bdubyalock/AAE451_Team7/README.md

# AAE451_Team7
GitHub Repo for AAE 451 Senior Design Team 7
Use this for CAD and code.
