bdubyalock/AAE451_Team7/Interfacing Design Review.pptx

## Mothership-Glider Interfacing

Team Trident, Team 7

7

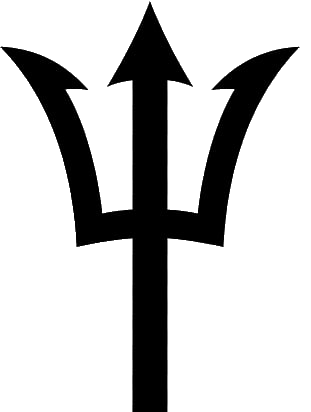
[picture p5: figure]

## Release mechanism

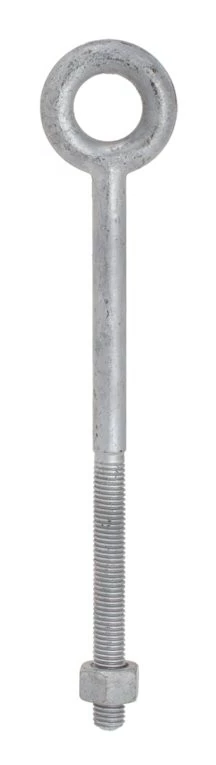
[picture p6: figure]
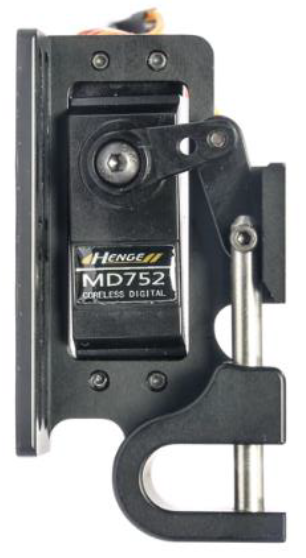
[picture p7: figure]
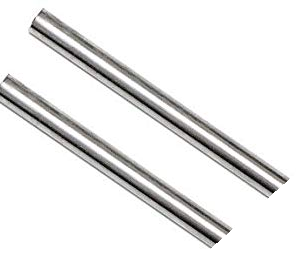
[picture p8: figure]

## Configuration

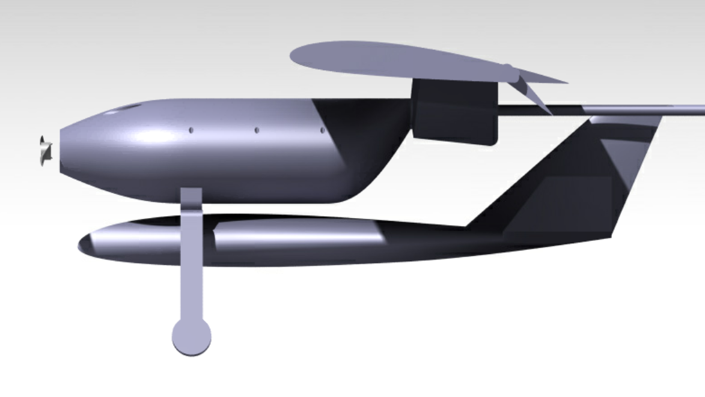
[picture p9: figure]

1 servo at the front
2 rods at the back

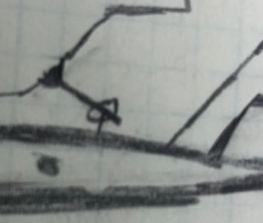
[picture p10: figure]

(top view) pin opening to the aft

## Slide 4

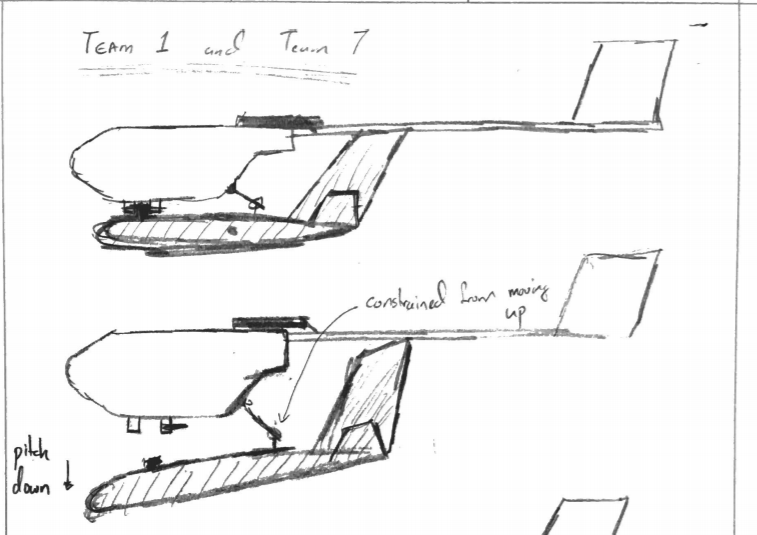
[picture p11: figure]

## Slide 5

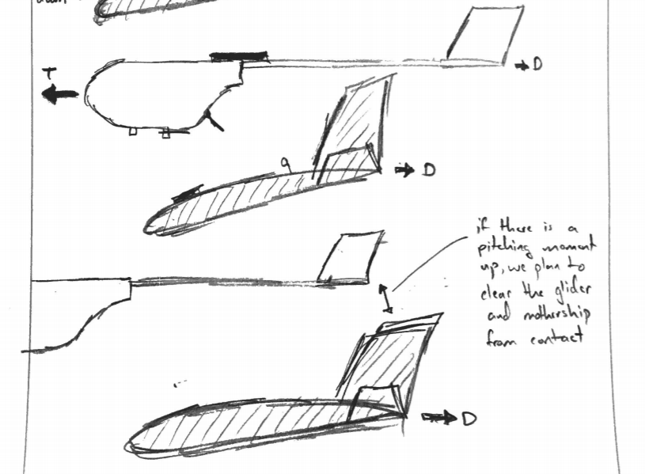
[picture p12: figure]
