bdubyalock/AAE451_Team7/PROPELLER_PDR_Design.xlsx

Sheet: RFP & Constraints
An electric UAV is needed to survey 10 km of roadway to detect surface damage. The UAV will fly at 20 m/sec at an altitude of 100 m carrying a 2 kg camera package. The UAV must be hand launched.
Two Constraints
•Cruise at 20 m/sec
•Hand Launch

Sheet: constraint
Criuse Speed |  |  |  | Hand Launch
 | rho | 1.225 | kg/m^3 | Clmax | 1.1
 | V | 18 | m/sec | Vlaunch | 9 | m/sec | 20 | mph
 | q | 198.45 | N/m^2 | q launch | 49.61 | N/m^2
 |  |  |  | W/S | 54.57 | N/m^2 | 0
 | AR | 5 |  |  | 54.57 | N/m^3 | 15
 | e | 0.9
 | Cdo | 0.0375
 | eta motor | 0.93
 | eta prop | 0.65
 | W/S | T/W | P/W
 | 20 | 0.3792225512 | 11.29198664
 | 22 | 0.3461087268 | 10.30596705
 | 24 | 0.3186326865 | 9.48782193
 | 26 | 0.2954934031 | 8.798811012
 | 28 | 0.2757615717 | 8.211262682
 | 30 | 0.2587557019 | 7.704884422
 | 32 | 0.2439646757 | 7.264456845
 | 34 | 0.2309976386 | 6.878341595
 | 36 | 0.2195505922 | 6.537486617
 | 38 | 0.2093835381 | 6.234745552
 | 40 | 0.2003044775 | 5.964401314
 | 42 | 0.1921579826 | 5.721825784
 | 44 | 0.1848168854 | 5.503232321
 | 46 | 0.1781761341 | 5.305492828
 | 48 | 0.1721481855 | 5.12600056
 | 50 | 0.1666595031 | 4.962565849
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
