bdubyalock/AAE451_Team7/Final_view1.jpg

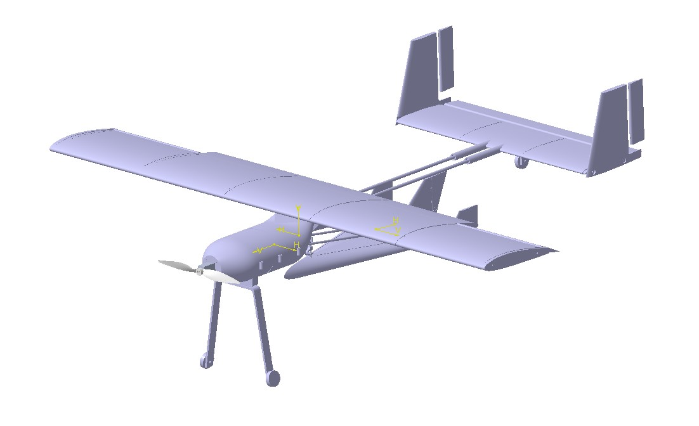
Final_view1.jpg
