bdubyalock/AAE451_Team7/Final_view2_color.jpg

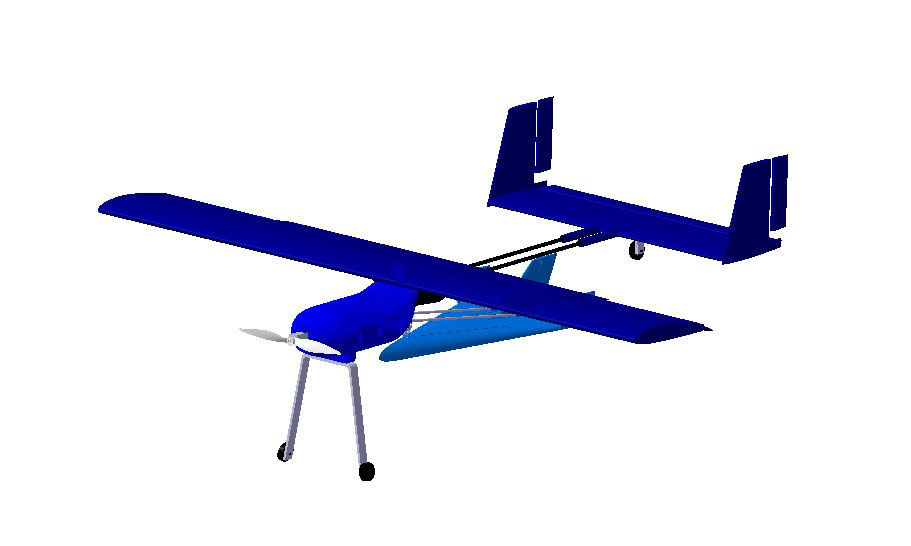
Final_view2_color.jpg
