bdubyalock/AAE451_Team7/FrontView.jpg

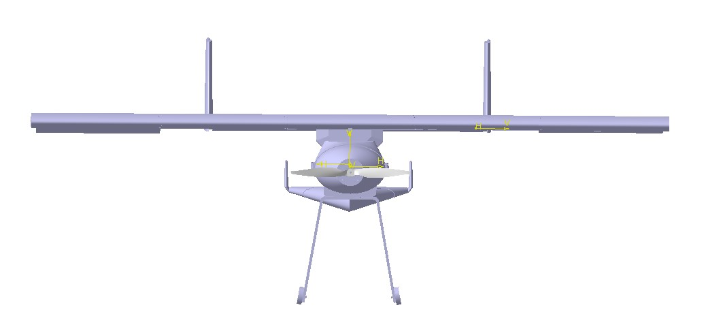
FrontView.jpg
