bdubyalock/AAE451_Team7/GliderAttachment.png

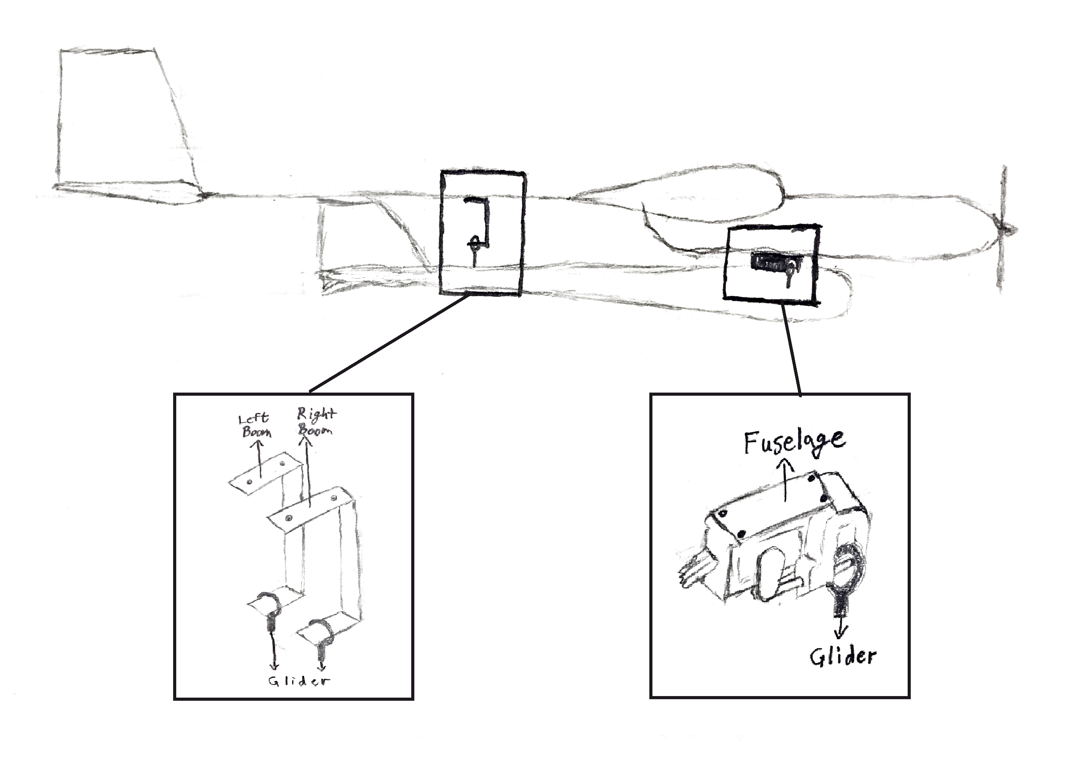
GliderAttachment.png
