bdubyalock/AAE451_Team7/SideView.jpg

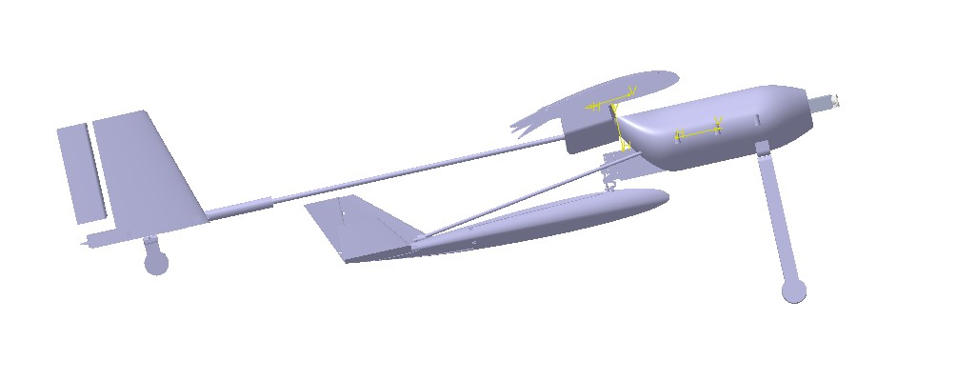
SideView.jpg
