bdubyalock/AAE451_Team7/ThreeView.jpg

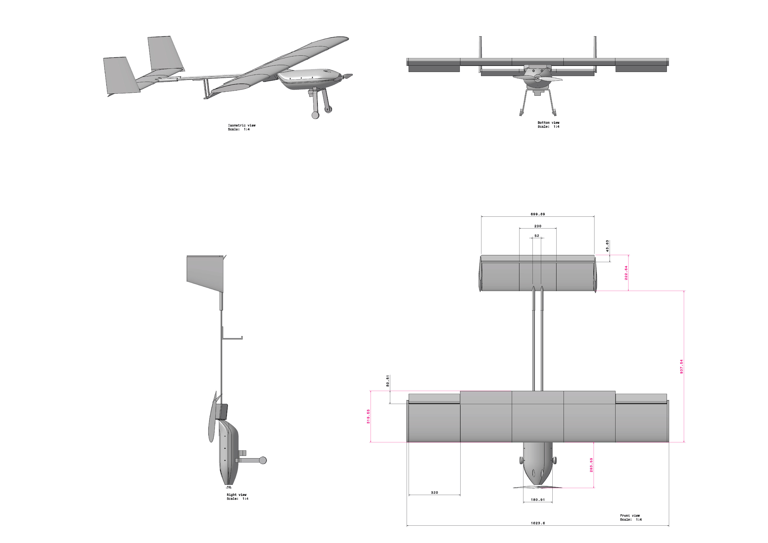
ThreeView.jpg
