bdubyalock/AAE451_Team7/TopView.jpg

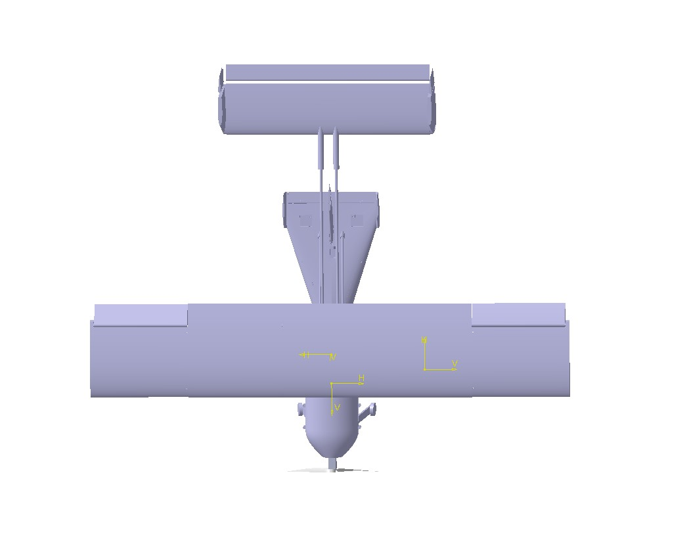
TopView.jpg
