bdubyalock/AAE451_Team7/CostSpreadsheet.xlsx

Sheet: Full
Task | Material Cost ($) | Labor Cost (Hours) | Labor Cost ($25/hr) | Total Cost | Labor Cost | 25
Preliminary Design Review
Team Design Meetings | $0.00 | 144.00 | $3600.00 | $3600.00
Report | $0.00 | 24.00 | $600.00 | $600.00
Project Plan Schedule
Develop | $0.00 | 6.00 | $150.00 | $150.00
Aerodynamics and Stability PDR
Aircraft Geometry | $0.00 | 12.00 | $300.00 | $300.00
Aerodynamic Performance | $0.00 | 5.00 | $125.00 | $125.00
Stability | $0.00 | 48.00 | $1200.00 | $1200.00
Propulsion PDR
Propeller Properties | $0.00 | 30.00 | $750.00 | $750.00
Aerodynamic Propeller Properites | $0.00 | 5.00 | $125.00 | $125.00
Gearbox Properties | $0.00 | 0.00 | $0.00 | $0.00
Electric Motor Properties | $0.00 | 3.00 | $75.00 | $75.00
Procedure Description | $0.00 | 1.00 | $25.00 | $25.00
Mission Requirements Analysis | $0.00 | 5.00 | $125.00 | $125.00
Structures and Weights PDR
Landing Gear | $0.00 | 6.00 | $150.00 | $150.00
Preliminary CAD | $0.00 | 5.00 | $125.00 | $125.00
Design Strategy
Analysis of Impulsive Loads | $0.00 | 4.00 | $100.00 | $100.00
Location, Configuraton, Special Structure, Load Analysis | $0.00 | 18.00 | $450.00 | $450.00
Longitudinal & Lateral tip-over analysis | $0.00 | 0.00 | $0.00 | $0.00
Tail Strike Analysis | $0.00 | 2.00 | $50.00 | $50.00
Weight Determination
Center of Gravity | $0.00 | 3.00 | $75.00 | $75.00
Moments/Products of Inertia | $0.00 | 0.50 | $12.50 | $12.50
Complete Tabular listing of all parts, locations, weights | $0.00 | 3.00 | $75.00 | $75.00
Geometric Layout
Geometry of Wing Spars | $0.00 | 1.00 | $25.00 | $25.00
Location of Wing Ribs & Stringers | $0.00 | 1.00 | $25.00 | $25.00
Wing Coverings, Materials of Wing Components | $0.00 | 1.00 | $25.00 | $25.00
Analysis of Wing Loads
V-n Diagram | $0.00 | 24.00 | $600.00 | $600.00
Max bending/torsional loading coefficients | $0.00 | 22.00 | $550.00 | $550.00
Load distribution @ max wing loading | $0.00 | 0.50 | $12.50 | $12.50
Max root bending moment | $0.00 | 0.50 | $12.50 | $12.50
Final Properties of Wing Box | $0.00 | 5.00 | $125.00 | $125.00
Assumptions/Failure conditions/Vertical Deflections | $0.00 | 2.00 | $50.00 | $50.00
Fuselage and Tail Structure
Analysis of Wing Fuselage Attachment | $0.00 | 2.00 | $50.00 | $50.00
Geometric layout of fuselage structure | $0.00 | 2.00 | $50.00 | $50.00
Geometric Layout of horizontal tail structure | $0.00 | 2.00 | $50.00 | $50.00
Geometric Layout of vertical tail structure | $0.00 | 2.00 | $50.00 | $50.00
Parts Acquisition List
Develop List | $0.00 | 2.00 | $50.00 | $50.00
CAD, Prototyping, Economic, Test Plan
CAD | $0.00 | 100.00 | $2500.00 | $2500.00
Manufacturing Report | $0.00 | 18.00 | $450.00 | $450.00
Build Schedule | $0.00 | 1.00 | $25.00 | $25.00
Economic Plan | $0.00 | 3.00 | $75.00 | $75.00
Flight Test Plan | $0.00 | 1.00 | $25.00 | $25.00
Critical Design Review (CDR)
Presentation Compilation | $0.00 | 6.00 | $150.00 | $150.00
Presentation Delivery | $0.00 | 3.00 | $75.00 | $75.00
Aerodynamic Analysis | $0.00 | 4.00 | $100.00 | $100.00
D&C Analysis | $0.00 | 6.00 | $150.00 | $150.00
Structural Analysis | $0.00 | 3.00 | $75.00 | $75.00
Propulsion Analysis | $0.00 | 4.00 | $100.00 | $100.00
Vehicle Performance Prediction | $0.00 | 6.00 | $150.00 | $150.00
Unique Aspects | $0.00 | 1.00 | $25.00 | $25.00
Remaining Design Problems/Solutions | $0.00 | 1.00 | $25.00 | $25.00
Conclusions | $0.00 | 1.00 | $25.00 | $25.00
Paper Copies of CDR Slides | $0.00 | 0.50 | $12.50 | $12.50
Aircraft Manufacturing
Main Wing | $15.35 | 2.00 | $50.00 | $65.35
Horizontal Stabilizer | $3.84 | 2.00 | $50.00 | $53.84
Vertical Stabilizers | $3.84 | 2.00 | $50.00 | $53.84
Fuselage | $5.76 | 4.00 | $100.00 | $105.76
Electrical Components | $900.00 | 0.00 | $0.00 | $900.00
Booms | $160.00 | 2.00 | $50.00 | $210.00
Landing Gear | $30.00 | 6.00 | $150.00 | $180.00
Aircraft Assembly
Structural Assembly | $0.00 | 15.00 | $375.00 | $375.00
Wiring | $40.00 | 10.00 | $250.00 | $290.00
Individual Component Testing | $0.00 | 10.00 | $250.00 | $250.00
Flight Test
Flight Readiness Review | $0.00 | 6.00 | $150.00 | $150.00
"Professional Pilot" Review | $0.00 | 6.00 | $150.00 | $150.00
System Ground Test | $0.00 | 12.00 | $300.00 | $300.00
Propulsion Check | $0.00 | 10.00 | $250.00 | $250.00
Mission Mechanism Check | $0.00 | 6.00 | $150.00 | $150.00
Overall Flight Test | $0.00 | 20.00 | $500.00 | $500.00
Final Flight (for score) | $0.00 | 20.00 | $500.00 | $500.00
Final Project Poster Presentation
Develop | $0.00 | 20.00 | $500.00 | $500.00
Present | $0.00 | 6.00 | $150.00 | $150.00
Final Design Report
Develop Report | $0.00 | 40.00 | $1000.00 | $1000.00
TOTALS: | $1158.78 | 749.00 | $18725.00 | $19883.78

Sheet: Sums
Task | Material Cost ($) | Labor Cost (Hours) | Labor Cost ($25/hr) | Total Cost | Labor Cost | 25 | Non-Concise
Preliminary Design Review | $0.00 | $168.00 | $4200.00 | $4200.00
Team Design Meetings | $0.00 | 144.00 | $3600.00 | $3600.00 |  |  | x
Report | $0.00 | 24.00 | $600.00 | $600.00 |  |  | x
Project Plan Schedule | $0.00 | $6.00 | $150.00 | $150.00
Develop | $0.00 | 6.00 | $150.00 | $150.00 |  |  | x
Aerodynamics and Stability PDR | $0.00 | $65.00 | $1625.00 | $1625.00
Aircraft Geometry | $0.00 | 12.00 | $300.00 | $300.00 |  |  | x
Aerodynamic Performance | $0.00 | 5.00 | $125.00 | $125.00 |  |  | x
Stability | $0.00 | 48.00 | $1200.00 | $1200.00 |  |  | x
Propulsion PDR | $0.00 | $44.00 | $1100.00 | $1100.00
Propeller Properties | $0.00 | 30.00 | $750.00 | $750.00 |  |  | x
Aerodynamic Propeller Properites | $0.00 | 5.00 | $125.00 | $125.00 |  |  | x
Gearbox Properties | $0.00 | 0.00 | $0.00 | $0.00 |  |  | x
Electric Motor Properties | $0.00 | 3.00 | $75.00 | $75.00 |  |  | x
Procedure Description | $0.00 | 1.00 | $25.00 | $25.00 |  |  | x
Mission Requirements Analysis | $0.00 | 5.00 | $125.00 | $125.00 |  |  | x
Structures and Weights PDR | $0.00 | $106.50 | $2662.50 | $2662.50
Landing Gear | $0.00 | 6.00 | $150.00 | $150.00 |  |  | x
Preliminary CAD | $0.00 | 5.00 | $125.00 | $125.00 |  |  | x
Design Strategy |  |  |  |  |  |  | x
Analysis of Impulsive Loads | $0.00 | 4.00 | $100.00 | $100.00 |  |  | x
Location, Configuraton, Special Structure, Load Analysis | $0.00 | 18.00 | $450.00 | $450.00 |  |  | x
Longitudinal & Lateral tip-over analysis | $0.00 | 0.00 | $0.00 | $0.00 |  |  | x
Tail Strike Analysis | $0.00 | 2.00 | $50.00 | $50.00 |  |  | x
Weight Determination |  |  |  |  |  |  | x
Center of Gravity | $0.00 | 3.00 | $75.00 | $75.00 |  |  | x
Moments/Products of Inertia | $0.00 | 0.50 | $12.50 | $12.50 |  |  | x
Complete Tabular listing of all parts, locations, weights | $0.00 | 3.00 | $75.00 | $75.00 |  |  | x
Geometric Layout |  |  |  |  |  |  | x
Geometry of Wing Spars | $0.00 | 1.00 | $25.00 | $25.00 |  |  | x
Location of Wing Ribs & Stringers | $0.00 | 1.00 | $25.00 | $25.00 |  |  | x
Wing Coverings, Materials of Wing Components | $0.00 | 1.00 | $25.00 | $25.00 |  |  | x
Analysis of Wing Loads |  |  |  |  |  |  | x
V-n Diagram | $0.00 | 24.00 | $600.00 | $600.00 |  |  | x
Max bending/torsional loading coefficients | $0.00 | 22.00 | $550.00 | $550.00 |  |  | x
Load distribution @ max wing loading | $0.00 | 0.50 | $12.50 | $12.50 |  |  | x
Max root bending moment | $0.00 | 0.50 | $12.50 | $12.50 |  |  | x
Final Properties of Wing Box | $0.00 | 5.00 | $125.00 | $125.00 |  |  | x
Assumptions/Failure conditions/Vertical Deflections | $0.00 | 2.00 | $50.00 | $50.00 |  |  | x
Fuselage and Tail Structure |  |  |  |  |  |  | x
Analysis of Wing Fuselage Attachment | $0.00 | 2.00 | $50.00 | $50.00 |  |  | x
Geometric layout of fuselage structure | $0.00 | 2.00 | $50.00 | $50.00 |  |  | x
Geometric Layout of horizontal tail structure | $0.00 | 2.00 | $50.00 | $50.00 |  |  | x
Geometric Layout of vertical tail structure | $0.00 | 2.00 | $50.00 | $50.00 |  |  | x
Parts Acquisition List | $0.00 | $2.00 | $50.00 | $50.00
Develop List | $0.00 | 2.00 | $50.00 | $50.00 |  |  | x
CAD, Prototyping, Economic, Test Plan | $0.00 | $123.00 | $3075.00 | $3075.00
CAD | $0.00 | 100.00 | $2500.00 | $2500.00 |  |  | x
Manufacturing Report | $0.00 | 18.00 | $450.00 | $450.00 |  |  | x
Build Schedule | $0.00 | 1.00 | $25.00 | $25.00 |  |  | x
Economic Plan | $0.00 | 3.00 | $75.00 | $75.00 |  |  | x
Flight Test Plan | $0.00 | 1.00 | $25.00 | $25.00 |  |  | x
Critical Design Review (CDR) | $0.00 | $35.50 | $887.50 | $887.50
Presentation Compilation | $0.00 | 6.00 | $150.00 | $150.00 |  |  | x
Presentation Delivery | $0.00 | 3.00 | $75.00 | $75.00 |  |  | x
Aerodynamic Analysis | $0.00 | 4.00 | $100.00 | $100.00 |  |  | x
D&C Analysis | $0.00 | 6.00 | $150.00 | $150.00 |  |  | x
Structural Analysis | $0.00 | 3.00 | $75.00 | $75.00 |  |  | x
Propulsion Analysis | $0.00 | 4.00 | $100.00 | $100.00 |  |  | x
Vehicle Performance Prediction | $0.00 | 6.00 | $150.00 | $150.00 |  |  | x
Unique Aspects | $0.00 | 1.00 | $25.00 | $25.00 |  |  | x
Remaining Design Problems/Solutions | $0.00 | 1.00 | $25.00 | $25.00 |  |  | x
Conclusions | $0.00 | 1.00 | $25.00 | $25.00 |  |  | x
Paper Copies of CDR Slides | $0.00 | 0.50 | $12.50 | $12.50 |  |  | x
Aircraft Manufacturing | $1118.78 | $18.00 | $450.00 | $1568.78
Main Wing | $15.35 | 2.00 | $50.00 | $65.35 |  |  | x
Horizontal Stabilizer | $3.84 | 2.00 | $50.00 | $53.84 |  |  | x
Vertical Stabilizers | $3.84 | 2.00 | $50.00 | $53.84 |  |  | x
Fuselage | $5.76 | 4.00 | $100.00 | $105.76 |  |  | x
Electrical Components | $900.00 | 0.00 | $0.00 | $900.00 |  |  | x
Booms | $160.00 | 2.00 | $50.00 | $210.00 |  |  | x
Landing Gear | $30.00 | 6.00 | $150.00 | $180.00 |  |  | x
Aircraft Assembly | $40.00 | $35.00 | $875.00 | $915.00
Structural Assembly | $0.00 | 15.00 | $375.00 | $375.00 |  |  | x
Wiring | $40.00 | 10.00 | $250.00 | $290.00 |  |  | x
Individual Component Testing | $0.00 | 10.00 | $250.00 | $250.00 |  |  | x
Flight Test | $0.00 | $80.00 | $2000.00 | $2000.00
Flight Readiness Review | $0.00 | 6.00 | $150.00 | $150.00 |  |  | x
"Professional Pilot" Review | $0.00 | 6.00 | $150.00 | $150.00 |  |  | x
System Ground Test | $0.00 | 12.00 | $300.00 | $300.00 |  |  | x
Propulsion Check | $0.00 | 10.00 | $250.00 | $250.00 |  |  | x
Mission Mechanism Check | $0.00 | 6.00 | $150.00 | $150.00 |  |  | x
Overall Flight Test | $0.00 | 20.00 | $500.00 | $500.00 |  |  | x
Final Flight (for score) | $0.00 | 20.00 | $500.00 | $500.00 |  |  | x
Final Project Poster Presentation | $0.00 | $26.00 | $650.00 | $650.00
Develop | $0.00 | 20.00 | $500.00 | $500.00 |  |  | x
Present | $0.00 | 6.00 | $150.00 | $150.00 |  |  | x
Final Design Report | $0.00 | $40.00 | $1000.00 | $1000.00
Develop Report | $0.00 | 40.00 | $1000.00 | $1000.00 |  |  | x
TOTALS: | $1158.78 | $749.00 | $18725.00 | $19883.78
