bdubyalock/AAE451_Team7/WeightEstimate.xlsx

Sheet: Filament Weight
PLA |  | ABS
PLA used [mm] | 3800 | ABS used [mm] | 50000
PLA diameter [mm] | 1.75 | ABS diameter [mm] | 1.75
PLA radius [mm] | 0.875 | ABS radius [mm] | 0.875
PLA volume [mm3] | 9140.071127 | ABS volume [mm3] | 120264.0938
PLA volume [cm3] | 9.14 | ABS volume [cm3] | 120.26
PLA density [g/cm3] | 1.25 | ABS density [g/cm3] | 1.04
PLA weight [g] | 11.43 | ABS weight [g] | 125.07
PLA weight [oz] | 0.40 | ABS weight [oz] | 4.41

Sheet: Part Weight Estimate
Part | Volume (cm^3) | Material | Weight (g) | Weight (kg) | NEW ESTIMATE (g) | NEW ESTIMATE (kg) | Total Weight (kg)
FuselageBodyTop | 792.863 | PLA | 991.07875 | 0.99107875 | 458.5588931 | 0.4585588931 | 13.59031875
FuselageBodyBase | 1148.221 | PLA | 1435.27625 | 1.43527625 | 664.0831402 | 0.6640831402 | 11.77631875
HSMID | 332.457 | PLA | 415.57125 | 0.41557125 | 192.2792638 | 0.1922792638
HSLH | 232.052 | PLA | 290.065 | 0.290065 | 134.2091991 | 0.1342091991 | Actual (kg)
HSRH | 232.052 | PLA | 290.065 | 0.290065 | 134.2091991 | 0.1342091991 | 7.359681971 | W Glider
WingMID | 643.093 | PLA | 803.86625 | 0.80386625 | 372 | 0.372 | 5.545681971 | W/o Glider
Wing_L_out | 444.547 | PLA | 555.68375 | 0.55568375 | 257.1074451 | 0.2571074451
Wing_L_in | 444.547 | PLA | 555.68375 | 0.55568375 | 257.1074451 | 0.2571074451
Wing_R_out | 444.547 | PLA | 555.68375 | 0.55568375 | 257.1074451 | 0.2571074451
Wing_L_in | 444.547 | PLA | 555.68375 | 0.55568375 | 257.1074451 | 0.2571074451
Elevator | 200.676 | PLA | 250.845 | 0.250845 | 116.0626293 | 0.1160626293
Flap x3 | 244.167 | PLA | 305.20875 | 0.91562625 | 141.2160099 | 0.1412160099
Flap x2 | 229.525 | PLA | 286.90625 | 0.5738125 | 132.7476877 | 0.1327476877
WingEndCap | 26.807 | PLA | 33.50875 | 0.0670175 | 15.50405082 | 0.01550405082
WingAttachment | 687.183 | PLA | 858.97875 | 0.85897875 | 397.4379884 | 0.3974379884
VS x2 | 449.052 | PLA | 561.315 | 1.12263 | 259.7129492 | 0.2597129492
Rudder | 58.841 | PLA | 73.55125 | 0.07355125 | 34.03118045 | 0.03403118045
Propeller |  |  | 46 | 0.046 |  | 0.046
Motor |  |  | 207 | 0.207 |  | 0.207
ESC |  |  | 106 | 0.106 |  | 0.106
Wires |  |  | 100 | 0.1 |  | 0.1
Battery |  |  | 600 | 0.6 |  | 0.6
Servos |  |  | 171 | 0.171 |  | 0.171
Carbon fiber rods |  |  | 235.2 | 0.2352 |  | 0.2352
glider |  |  |  | 1.814 |  | 1.814
