bdubyalock/AAE451_Team7/AA-SM-518 Loads - V-n Diagram -Sarah.xlsx

Sheet: READ ME
Author: | R. Abbott |  | Total Report Pages:
Check: |  |  | Report:
Date: |  |  | Revision:
Section Number: |  |  | Sheet Name | IMPORTANT INFORMATION
Report Title:
Section:
 | IMPORTANT INFORMATION
About us:
Established in Canada 2008 we relocated to Grand Cayman in 2015. Abbott Aerospace SEZC Ltd. specializes in helping our partners bring the best aircraft product to market in the shortest time. We help you define your aircraft and execute your development program.
About the Abbott Aerospace Analysis Spreadsheets:
Our in-house structural analysis toolbox is our collection of spreadsheets, we make these available for free to anyone who wants to use them. To keep up to date with our latest spreadsheet news and subscibe to our regular newsletter please click this link.
 |  |  | http://www.abbottaerospace.com/subscribe
The spreadsheets are intended to be used by engineers. They are not protected software packages and can be changed in every way by the user.
All of our spreadsheets are provided 'as is' with no warranty or guarantee explicitly given or implied. You use these spreadsheets at your own risk. The Author will not be liable for data loss, damages, loss of profits or any other kind of loss while using or misusing these spreadsheets We have made every reasonable effort to remove all errors but some may still exist and all analysis work should be thoroughly checked. If you do find errors plese notify us at:
 |  | spreadsheets@abbottaerospace.com
Proprietary information:
The spreadsheets contain no proprietary information from outside of Abbott Aerospace SEZC Ltd. If you think that we have used proprietary information inappropriately please let us know.
Abbott Aerospace SEZC Ltd. grants the user the right to use, modify, reproduce and redistribute these spreadsheets. We just ask that if possible you maintain a credit naming Abbott Aerospace SEZC Ltd. as the source.
Our analysis spreadsheets in general do not use Visual Basic routines and the outcome of the analysis in the spreadsheets rely solely on native Excel functions. The display of the math in these sheets rely on the XL-Viking add-in and the spreadsheets will not display correcly if the add-in is not installed.
To find out more about the Xl-Viking Add-in and to download it for free:
 |  |  | http://www.xl-viking.com/download-free-trial/
Support:
You can help support the work of the Abbott Aerospace Technical Library. We provide all of our library services without a mandatory charge. We rely on the goodwill of our users making voluntary donatations to help us support and expand the services we provide. Click the link below to make a donation.
Find out more about the Design and Analysis services provided by Abbott Aerospace
 |  |  | http://www.abbottaerospace.com/engineering-services

Sheet: Analysis
Author: | R. Abbott |  |  | Total Report Pages: | 1 |  |  |  |  | Page | Title | Sub | Sub | Sub | Fig | Table | Running Counts |  | Total Sheet Pages: | 1
Check: |  |  |  | Report: | AA-SM-518 |  |  |  |  | No | No | Title | Title | Title | No | No |  |  | Total Title No: | 0
Date: | 7/16/2016 |  |  | Revision: | IR |  |  |  |  |  |  |  |  |  |  |  |  |  | Total Sub No: | 0
Section Number: |  |  |  | Sheet Name | V-n DIAGRAM |  |  |  |  |  |  |  |  |  |  |  |  |  | Total Sub No: | 0
Report Title: | STANDARD SPREADSHEET METHOD |  |  |  |  |  |  |  |  |  |  |  |  |  |  |  |  |  | Total Sub No: | 0
Section: |  |  |  |  |  |  |  |  |  |  |  |  |  |  |  |  |  |  | Total Fig No: | 0
 |  |  |  |  |  |  |  |  |  |  |  |  |  |  |  |  |  |  | Total Table No: | 0
 |  |  | Author: | R. Abbott |  |  | Document Number: | AA-SM-518
 |  |  | Check: |  |  |  | Revision Level : | IR |  | 1
 |  |  | Date: | 7/16/2016 |  |  | Page: | 1 of 1 | 1
 |  |  | Title: | STANDARD SPREADSHEET METHOD
V-n DIAGRAM
 |  |  | Maneuver |  |  |  | Gust |  |  |  |  |  |  |  |  |  |  | Point A: | V = |  | V = | 62.6 | GUST LINES
 |  |  | Normal |  | Utility |  |  |  |  |  |  |  |  |  |  |  |  |  | n = |  | n = | 4.40 |  |  |  |  |  | 63.0 | 5.75
 |  |  | +ve | -ve | +ve | -ve | +ve | -ve |  |  |  |  |  |  |  |  |  |  |  |  |  |  | 0 | 1 | 1 | 1 | 1 | 88.2 | 3.68
vA = | 62.6 | kts (EAS) | 4.60 | -1.84 | 4.40 | -1.76 |  |  |  |  |  |  |  |  |  |  |  | Point D: | V = |  | V = | 88.2 | 63.0 | 5.75 | -3.50 |  |  | 88.2 | -1.50
vC = | 63.0 | kts (EAS) | 4.60 | -1.84 | 4.40 | -1.76 | 5.75 | -3.50 |  |  |  |  |  |  |  |  |  |  | n = |  | n = | 4.40 |  |  |  |  |  | 63.0 | -3.50
vD = | 88.2 | kts (EAS) | 4.60 | 0.00 | 4.40 | -1.00 | 3.68 | -1.50 |  |  |  |  |  |  |  |  |  |  |  |  |  |  |  |  |  |  |  | 63.0 | 5.75
vS1 = | 29.2 | kts (EAS) |  |  |  |  |  |  |  |  |  |  |  |  |  |  |  | Point E: | V = |  | V = | 88.2 | 0 |  |  | 1 | 1
 |  |  |  |  |  |  |  |  |  |  |  |  |  |  |  |  |  |  | n = |  | n = | -1.00 | 88.2 |  |  | 3.68 | -1.50
The flight envelope is determined in accordance with 23.333
 |  |  |  |  |  |  |  |  |  |  |  |  |  |  |  |  |  | Point F: | V = |  | V = | 63.0
 |  |  |  |  |  |  |  |  |  |  |  |  |  |  |  |  |  |  | n = |  | n = | -3.50
 |  |  |  |  |  |  |  |  |  |  |  |  |  |  |  |  |  | Point G: | V = |  | V = | 62.6
 |  |  |  |  |  |  |  |  |  |  |  |  |  |  |  |  |  |  | n = |  | n = | -1.76
 |  |  |  |  |  |  |  |  |  |  |  |  |  |  |  |  |  | Point C: | V = |  | V = | 63.0
 |  |  |  |  |  |  |  |  |  |  |  |  |  |  |  |  |  |  | n = |  | n = | 5.75
 |  |  |  |  |  |  |  |  |  |  |  |  |  |  |  |  |  |  | 62.6 | 4.60 | 62.6 | 4.40
 |  |  |  |  |  |  |  |  |  |  |  |  |  |  |  |  |  |  | 88.2 | 4.60 | 88.2 | 4.4
 |  |  |  |  |  |  |  |  |  |  |  |  |  |  |  |  |  |  | 88.2 | 0.00 | 88.2 | -1.00
 |  |  |  |  |  |  |  |  |  |  |  |  |  |  |  |  |  |  | 63.0 | -1.84 | 63.0 | -1.76
 |  |  |  |  |  |  |  |  |  |  |  |  |  |  |  |  |  |  | 62.6 | -1.84 | 62.6 | -1.76
 |  |  |  |  |  |  |  |  |  |  |  |  |  |  |  |  |  |  | Normal |  | Utility
 |  |  |  |  |  |  |  |  |  |  |  |  |  |  |  |  |  |  |  |  |  |  | 29.2 | 32.95370989 | 1.221001221 | 0.969
 |  |  |  |  |  |  |  |  |  |  |  |  |  |  |  |  |  | 62.55652319 | 4.60 | -1.84 | 4.40 | -1.76 |  | 26.05219515 | 0.7631257631
 |  |  |  |  |  |  |  |  |  |  |  |  |  |  |  |  |  | 59.64530458 | 4.18 | -1.67 | 4.00 | -1.60
 |  |  |  |  |  |  |  |  |  |  |  |  |  |  |  |  |  | 54.44846461 | 3.49 | -1.39 | 3.33 | -1.33 |  | 32.95370989 | -0.4884004884 | -0.388
 |  |  |  |  |  |  |  |  |  |  |  |  |  |  |  |  |  | 47.75446253 | 2.68 | -1.07 | 2.56 | -1.03 |  | 26.05219515 | -0.3052503053
 |  |  |  |  |  |  |  |  |  |  |  |  |  |  |  |  |  | 40.35988719 | 1.92 | -0.77 | 1.83 | -0.73
 |  |  |  |  |  |  |  |  |  |  |  |  |  |  |  |  |  | 32.95370989 | 1.28 | -0.51 | 1.22 | -0.49
 |  |  |  |  |  |  |  |  |  |  |  |  |  |  |  |  |  | 26.05219515 | 0.80 | -0.32 | 0.76 | -0.31 | 29.2 | -0.388
 |  |  |  |  |  |  |  |  |  |  |  |  |  |  |  |  |  | 24.83979345 | 0.73 | -0.29 | 0.69 | -0.28 | 29.2 | 0.969
 |  |  |  |  |  |  |  |  |  |  |  |  |  |  |  |  |  | 18.5144889 | 0.40 | -0.16 | 0.39 | -0.15
 |  |  |  |  |  |  |  |  |  |  |  |  |  |  |  |  |  | 13.43182198 | 0.21 | -0.08 | 0.20 | -0.08
 |  |  |  |  |  |  |  |  |  |  |  |  |  |  |  |  |  | 9.497732405 | 0.11 | -0.04 | 0.10 | -0.04
 |  | Utility Category Maneuver Envelope |  |  |  |  |  |  |  |  |  |  |  |  |  |  |  | 6.715910989 | 0.05 | -0.02 | 0.05 | -0.02
 |  | Gust Lines |  |  |  |  |  |  |  |  |  |  |  |  |  |  |  | 4.748866202 | 0.03 | -0.01 | 0.03 | -0.01
 |  | Normal Category Maneuver Envelope |  |  |  |  |  |  |  |  |  |  |  |  |  |  |  | 3.357955495 | 0.01 | -0.01 | 0.01 | -0.01
 |  | Stall (Flaps Extended) Cut off |  |  |  |  |  |  |  |  |  |  |  |  |  |  |  | 2.374433101 | 0.01 | -0.00265219119 | 0.01 | -0.002535638501
 |  |  |  |  |  |  |  |  |  |  |  |  |  |  |  |  |  | 1.678977747 | 0.003315238987 | -0.001326095595 | 0.003169548126 | -0.00126781925
 |  |  |  |  |  |  |  |  |  |  |  |  |  |  |  |  |  | 0 | 0.00 | 0.00 | 0.00 | 0.00
 |  |  |  | If you see errors on this spreadsheet it is because you do not have the XL-Viking Plugin, to find out more:
 |  |  |  | www.xl-viking.com

Sheet: Calculations
stall lines |  |  | rho | V | S | Clmax/flap | Clmax
n+ | n- |  | 1.225 | 21 | 0.512 | 2 | 1.2
4.602249584 | -2.76134975 |  | VH | w0 | VS | Clmin
Vcmin | Vcmax |  | 36 | 60.1 | 15 | -1.2
15.74340958 | 32.4 |  |  | 13.5
VD | VA+ | VA-
45.36 | 32.17928148 | 21
