bdubyalock/AAE451_Team7/AA-SM-518 Loads - V-n Diagram.xlsx

Sheet: READ ME
Author: | R. Abbott |  | Total Report Pages:
Check: |  |  | Report:
Date: |  |  | Revision:
Section Number: |  |  | Sheet Name | IMPORTANT INFORMATION
Report Title:
Section:
 | IMPORTANT INFORMATION
About us:
Established in Canada 2008 we relocated to Grand Cayman in 2015. Abbott Aerospace SEZC Ltd. specializes in helping our partners bring the best aircraft product to market in the shortest time. We help you define your aircraft and execute your development program.
About the Abbott Aerospace Analysis Spreadsheets:
Our in-house structural analysis toolbox is our collection of spreadsheets, we make these available for free to anyone who wants to use them. To keep up to date with our latest spreadsheet news and subscibe to our regular newsletter please click this link.
 |  |  | http://www.abbottaerospace.com/subscribe
The spreadsheets are intended to be used by engineers. They are not protected software packages and can be changed in every way by the user.
All of our spreadsheets are provided 'as is' with no warranty or guarantee explicitly given or implied. You use these spreadsheets at your own risk. The Author will not be liable for data loss, damages, loss of profits or any other kind of loss while using or misusing these spreadsheets We have made every reasonable effort to remove all errors but some may still exist and all analysis work should be thoroughly checked. If you do find errors plese notify us at:
 |  | spreadsheets@abbottaerospace.com
Proprietary information:
The spreadsheets contain no proprietary information from outside of Abbott Aerospace SEZC Ltd. If you think that we have used proprietary information inappropriately please let us know.
Abbott Aerospace SEZC Ltd. grants the user the right to use, modify, reproduce and redistribute these spreadsheets. We just ask that if possible you maintain a credit naming Abbott Aerospace SEZC Ltd. as the source.
Our analysis spreadsheets in general do not use Visual Basic routines and the outcome of the analysis in the spreadsheets rely solely on native Excel functions. The display of the math in these sheets rely on the XL-Viking add-in and the spreadsheets will not display correcly if the add-in is not installed.
To find out more about the Xl-Viking Add-in and to download it for free:
 |  |  | http://www.xl-viking.com/download-free-trial/
Support:
You can help support the work of the Abbott Aerospace Technical Library. We provide all of our library services without a mandatory charge. We rely on the goodwill of our users making voluntary donatations to help us support and expand the services we provide. Click the link below to make a donation.
Find out more about the Design and Analysis services provided by Abbott Aerospace
 |  |  | http://www.abbottaerospace.com/engineering-services

Sheet: Analysis
 | Author: | R. Abbott |  |  | Total Report Pages: | 1 |  |  |  |  | Page | Title | Sub | Sub | Sub | Fig | Table | Running Counts |  | Total Sheet Pages: | 1
 | Check: |  |  |  | Report: | AA-SM-518 |  |  |  |  | No | No | Title | Title | Title | No | No |  |  | Total Title No: | 0
 | Date: | 7/16/2016 |  |  | Revision: | IR |  |  |  |  |  |  |  |  |  |  |  |  |  | Total Sub No: | 0
 | Section Number: |  |  |  | Sheet Name | V-n DIAGRAM |  |  |  |  |  |  |  |  |  |  |  |  |  | Total Sub No: | 0
 | Report Title: | STANDARD SPREADSHEET METHOD |  |  |  |  |  |  |  |  |  |  |  |  |  |  |  |  |  | Total Sub No: | 0
 | Section: |  |  |  |  |  |  |  |  |  |  |  |  |  |  |  |  |  |  | Total Fig No: | 0
 |  |  |  |  |  |  |  |  |  |  |  |  |  |  |  |  |  |  |  | Total Table No: | 0
 |  |  |  | Author: | R. Abbott |  |  | Document Number: | AA-SM-518
 |  |  |  | Check: |  |  |  | Revision Level : | IR |  | 1
 |  |  |  | Date: | 7/16/2016 |  |  | Page: | 1 of 1 | 1
 |  |  |  | Title: | STANDARD SPREADSHEET METHOD
 | V-n DIAGRAM
 |  |  |  | Maneuver |  |  |  | Gust |  |  |  |  |  |  |  |  |  |  | Point A: | V = |  | V = | 29.2 | GUST LINES
 |  |  |  | Normal |  | Utility |  |  |  |  |  |  |  |  |  |  |  |  |  | n = |  | n = | 4.40 |  |  |  |  |  | 35.0 | 5.75
 |  |  |  | +ve | -ve | +ve | -ve | +ve | -ve |  |  |  |  |  |  |  |  |  |  |  |  |  |  | 0 | 1 | 1 | 1 | 1 | 44.1 | 3.68
manuever | vA = | 29.2 | kts (EAS) | 3.80 | -1.52 | 4.40 | -1.76 |  |  |  |  |  |  |  |  |  |  |  | Point D: | V = |  | V = | 44.1 | 35.0 | 5.75 | -3.50 |  |  | 44.1 | -1.50
cruise | vC = | 35.0 | kts (EAS) | 3.80 | -1.52 | 4.40 | -1.76 | 5.75 | -3.50 |  |  |  |  |  |  |  |  |  |  | n = |  | n = | 4.40 |  |  |  |  |  | 35.0 | -3.50
max speed without flutter | vD = | 44.1 | kts (EAS) | 3.80 | 0.00 | 4.40 | -1.00 | 3.68 | -1.50 |  |  |  |  |  |  |  |  |  |  |  |  |  |  |  |  |  |  |  | 35.0 | 5.75
stall | vS1 = | 20.0 | kts (EAS) |  |  |  |  |  |  |  |  |  |  |  |  |  |  |  | Point E: | V = |  | V = | 44.1 | 0 |  |  | 1 | 1
 |  |  |  |  |  |  |  |  |  |  |  |  |  |  |  |  |  |  |  | n = |  | n = | -1.00 | 44.1 |  |  | 3.68 | -1.50
 | The flight envelope is determined in accordance with 23.333
 |  |  |  |  |  |  |  |  |  |  |  |  |  |  |  |  |  |  | Point F: | V = |  | V = | 35.0
 |  |  |  |  |  |  |  |  |  |  |  |  |  |  |  |  |  |  |  | n = |  | n = | -3.50
 |  |  |  |  |  |  |  |  |  |  |  |  |  |  |  |  |  |  | Point G: | V = |  | V = | 29.2
 |  |  |  |  |  |  |  |  |  |  |  |  |  |  |  |  |  |  |  | n = |  | n = | -1.76
 |  |  |  |  |  |  |  |  |  |  |  |  |  |  |  |  |  |  | Point C: | V = |  | V = | 35.0
 |  |  |  |  |  |  |  |  |  |  |  |  |  |  |  |  |  |  |  | n = |  | n = | 5.75
 |  |  |  |  |  |  |  |  |  |  |  |  |  |  |  |  |  |  |  | 29.2 | 3.80 | 29.2 | 4.40
 |  |  |  |  |  |  |  |  |  |  |  |  |  |  |  |  |  |  |  | 44.1 | 3.80 | 44.1 | 4.4
 |  |  |  |  |  |  |  |  |  |  |  |  |  |  |  |  |  |  |  | 44.1 | 0.00 | 44.1 | -1.00
 |  |  |  |  |  |  |  |  |  |  |  |  |  |  |  |  |  |  |  | 35.0 | -1.52 | 35.0 | -1.76
 |  |  |  |  |  |  |  |  |  |  |  |  |  |  |  |  |  |  |  | 29.2 | -1.52 | 29.2 | -1.76
 |  |  |  |  |  |  |  |  |  |  |  |  |  |  |  |  |  |  |  | Normal |  | Utility
 |  |  |  |  |  |  |  |  |  |  |  |  |  |  |  |  |  |  |  |  |  |  |  | 20.0 | 22.2907258 | 2.564102564 | 2.078
 |  |  |  |  |  |  |  |  |  |  |  |  |  |  |  |  |  |  | 29.2 | 3.80 | -1.52 | 4.40 | -1.76 |  | 18.83910175 | 1.831501832
 |  |  |  |  |  |  |  |  |  |  |  |  |  |  |  |  |  |  | 27.84110761 | 3.45 | -1.38 | 4.00 | -1.60
 |  |  |  |  |  |  |  |  |  |  |  |  |  |  |  |  |  |  | 25.41533777 | 2.88 | -1.15 | 3.33 | -1.33 |  | 22.2907258 | -1.025641026 | -0.831
 |  |  |  |  |  |  |  |  |  |  |  |  |  |  |  |  |  |  | 22.2907258 | 2.21 | -0.89 | 2.56 | -1.03 |  | 18.83910175 | -0.7326007326
 |  |  |  |  |  |  |  |  |  |  |  |  |  |  |  |  |  |  | 18.83910175 | 1.58 | -0.63 | 1.83 | -0.73
 |  |  |  |  |  |  |  |  |  |  |  |  |  |  |  |  |  |  | 15.38206217 | 1.05 | -0.42 | 1.22 | -0.49
 |  |  |  |  |  |  |  |  |  |  |  |  |  |  |  |  |  |  | 12.16058789 | 0.66 | -0.26 | 0.76 | -0.31 | 20.0 | -0.831
 |  |  |  |  |  |  |  |  |  |  |  |  |  |  |  |  |  |  | 11.59466562 | 0.60 | -0.24 | 0.69 | -0.28 | 20.0 | 2.078
 |  |  |  |  |  |  |  |  |  |  |  |  |  |  |  |  |  |  | 8.6421535 | 0.33 | -0.13 | 0.39 | -0.15
 |  |  |  |  |  |  |  |  |  |  |  |  |  |  |  |  |  |  | 6.269677114 | 0.18 | -0.07 | 0.20 | -0.08
 |  |  |  |  |  |  |  |  |  |  |  |  |  |  |  |  |  |  | 4.433331203 | 0.09 | -0.04 | 0.10 | -0.04
 |  |  | Utility Category Maneuver Envelope |  |  |  |  |  |  |  |  |  |  |  |  |  |  |  | 3.134838557 | 0.04 | -0.02 | 0.05 | -0.02
 |  |  | Gust Lines |  |  |  |  |  |  |  |  |  |  |  |  |  |  |  | 2.216665602 | 0.02 | -0.01 | 0.03 | -0.01
 |  |  | Normal Category Maneuver Envelope |  |  |  |  |  |  |  |  |  |  |  |  |  |  |  | 1.567419278 | 0.01 | -0.004379739228 | 0.01 | -0.01
 |  |  | Stall (Flaps Extended) Cut off |  |  |  |  |  |  |  |  |  |  |  |  |  |  |  | 1.108332801 | 0.01 | -0.002189869614 | 0.01 | -0.002535638501
 |  |  |  |  |  |  |  |  |  |  |  |  |  |  |  |  |  |  | 0.7837096392 | 0.002737337018 | -0.001094934807 | 0.003169548126 | -0.00126781925
 |  |  |  |  |  |  |  |  |  |  |  |  |  |  |  |  |  |  | 0 | 0.00 | 0.00 | 0.00 | 0.00
 |  |  |  |  | If you see errors on this spreadsheet it is because you do not have the XL-Viking Plugin, to find out more:
 |  |  |  |  | www.xl-viking.com
