bdubyalock/AAE451_Team7/Electrical Components.PNG

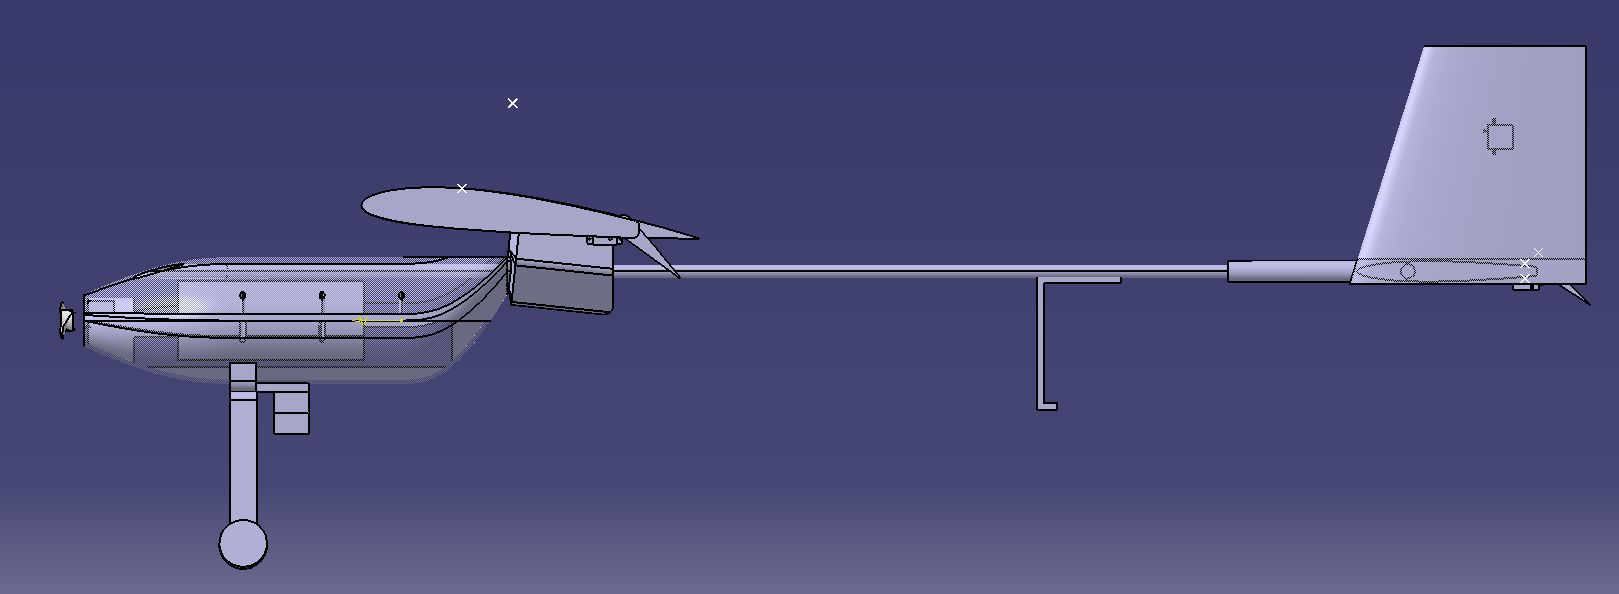
Electrical Components.PNG
