bdubyalock/AAE451_Team7/Assembly_11-21/AAE451_T7_FuselageAssemble_V2/AAE451_T7_FuselageAssemble_V2/AAE451_T7_HEATSET_8_32.STEP

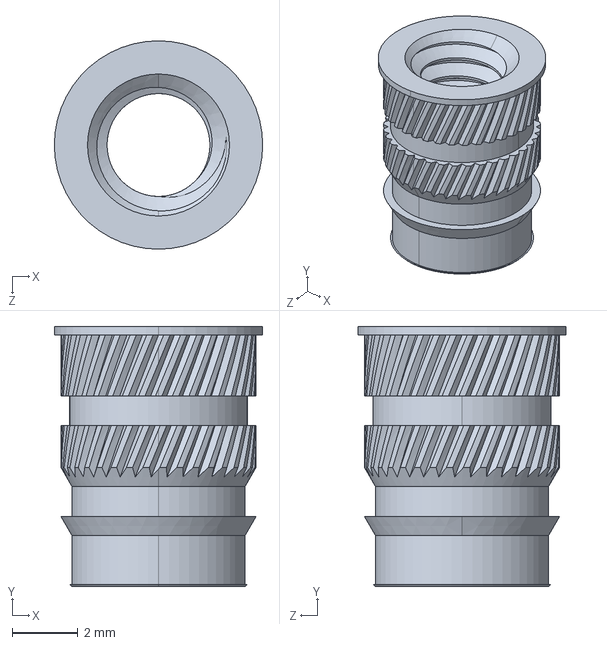
[picture p43: CAD file, 2019-11-21]
Assembly_11-21/AAE451_T7_FuselageAssemble_V2/AAE451_T7_FuselageAssemble_V2/AAE451_T7_HEATSET_8_32.STEP
6.35 x 7.92 x 6.35 mm
