bdubyalock/AAE451_Team7/Assembly_11-21/AAE451_T7_WingAssembly_V6/AAE451_T7_WingAssembly_V2/AAE451_T7_WingMID_V2.stl

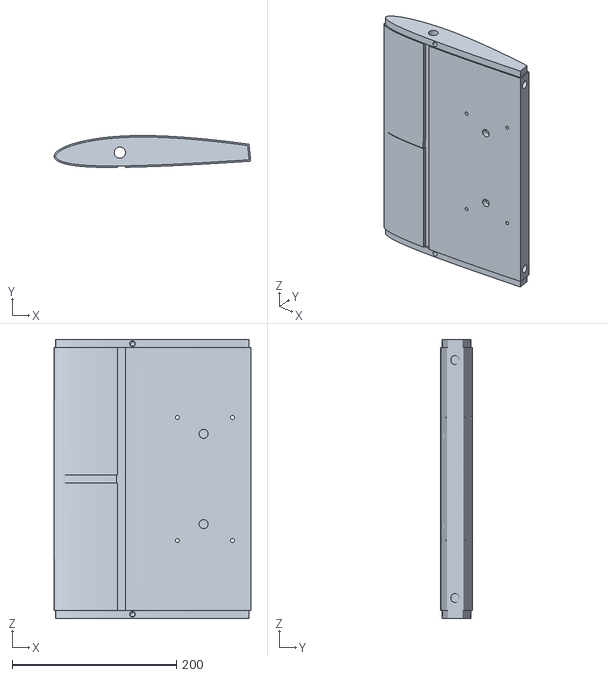
[picture p44: CAD file, 2019-12-07]
Assembly_11-21/AAE451_T7_WingAssembly_V6/AAE451_T7_WingAssembly_V2/AAE451_T7_WingMID_V2.stl
239.6 x 38.9 x 340.0
