bdubyalock/AAE451_Team7/ESC.STEP

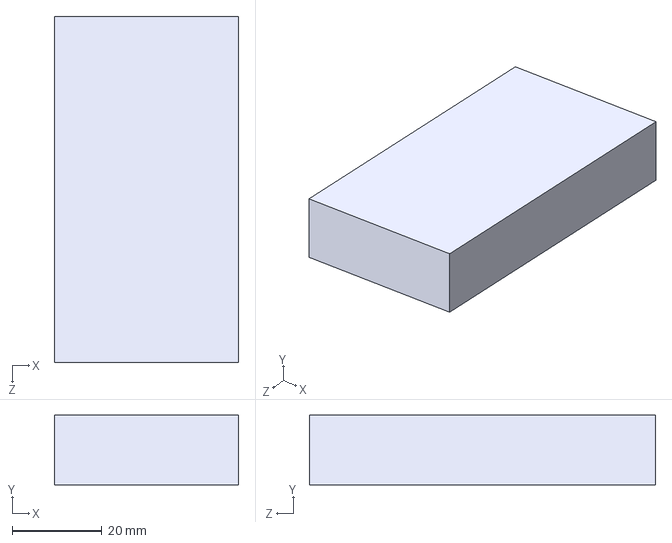
[picture p45: CAD file, 2019-10-13]
ESC.STEP
41.0 x 15.5 x 77.0 mm
