bdubyalock/AAE451_Team7/motor.STEP

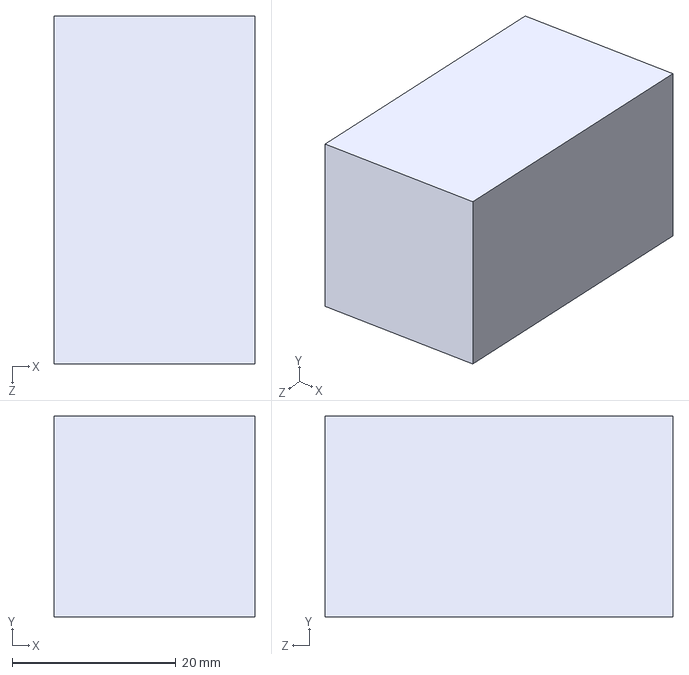
[picture p47: CAD file, 2019-10-13]
motor.STEP
24.5 x 24.5 x 42.5 mm
