bdubyalock/AAE451_Team7/AR8000.stl

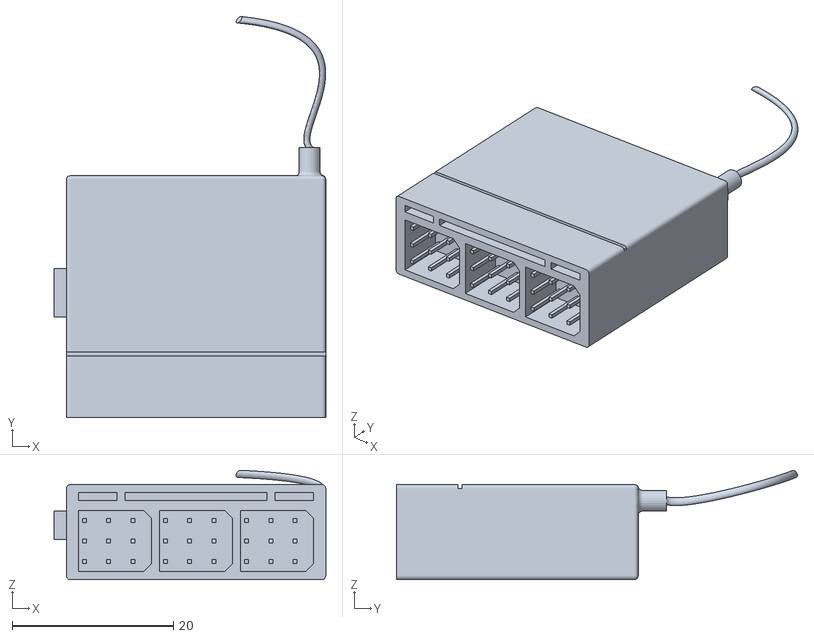
[picture p48: CAD file, 2019-10-12]
AR8000.stl
33.7 x 49.8 x 13.6
