bdubyalock/AAE451_Team7/Assembly_11-21/AAE451_T7_TailAssembly_V2/AAE451_T7_Elevator_V2_6.stl

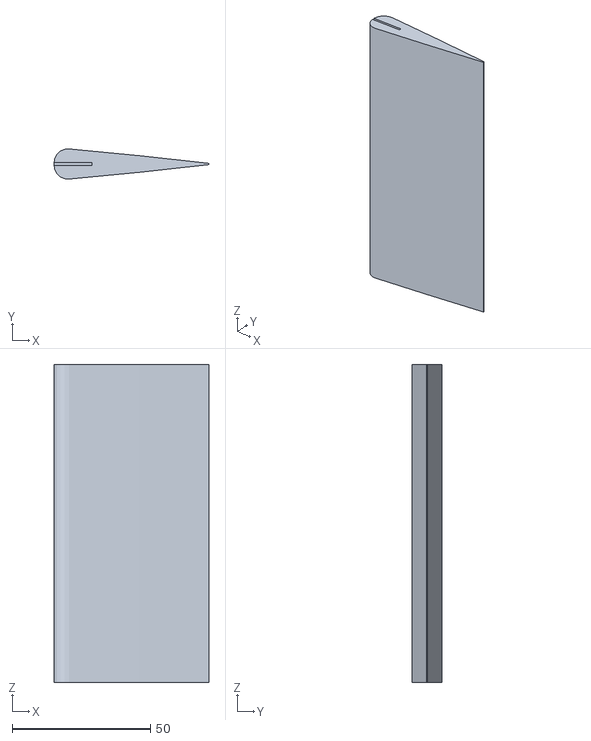
[picture p49: CAD file, 2019-11-21]
Assembly_11-21/AAE451_T7_TailAssembly_V2/AAE451_T7_Elevator_V2_6.stl
56.0 x 10.9 x 115.0
