bdubyalock/AAE451_Team7/Batt.SLDPRT

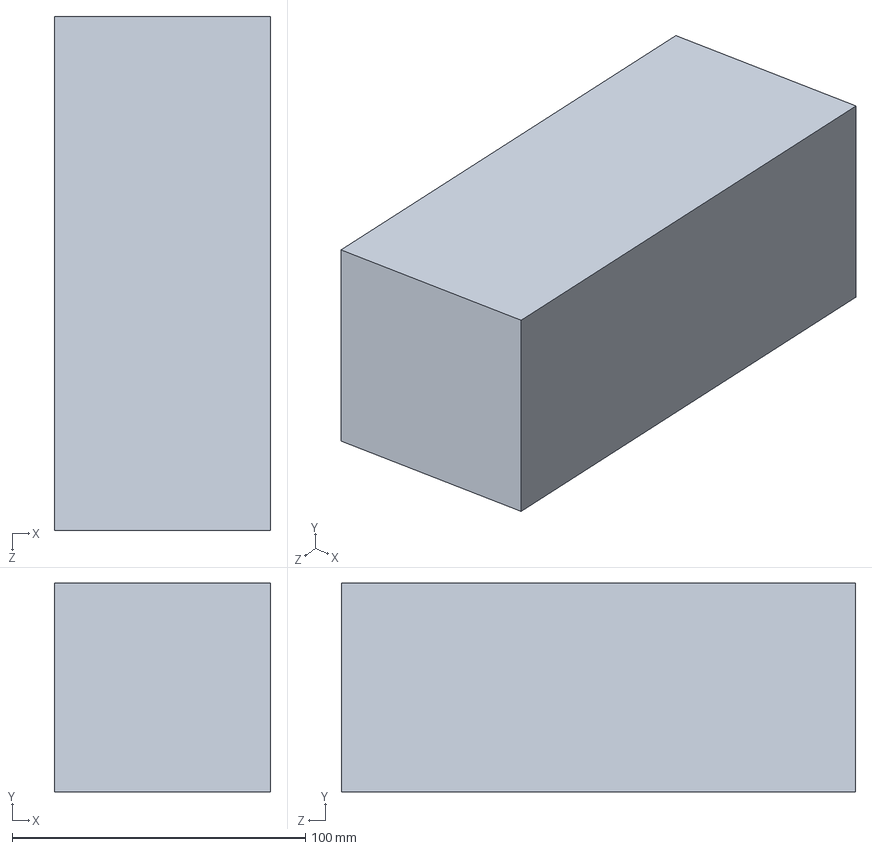
[picture p50: CAD file, 2019-10-12]
Batt.SLDPRT
73.7 x 71.1 x 175.3 mm
