bdubyalock/AAE451_Team7/(list of files, cad)

Other CAD files:
Assembly_11-21/AAE451_T7_WingAssembly_V6/AAE451_T7_WingAssembly_V2/AAE451_T7_Wing_L_out_V2.stl
Assembly_11-21/AAE451_T7_TailAssembly_V2/AAE451_T7_Elevator_V2_5.stl
Assembly_11-21/AAE451_T7_TailAssembly_V2/AAE451_T7_Elevator_V2_4.stl
Assembly_11-21/AAE451_T7_TailAssembly_V2/AAE451_T7_Elevator_V2_2.stl
Assembly_11-21/AAE451_T7_TailAssembly_V2/AAE451_T7_Elevator_V2_3.stl
Assembly_11-21/AAE451_T7_TailAssembly_V2/AAE451_T7_Elevator_V2_1.stl
AAE451_T7_AftGliderInterface.CATPart
AAE451_T7_AftLandingGear.CATProduct
AAE451_T7_Battery.CATPart
AAE451_T7_Boom.CATPart
AAE451_T7_BrassInsertTest.CATPart
AAE451_T7_ElectronicPlatform.CATPart
AAE451_T7_Elevator.CATPart
AAE451_T7_FULLFINALASSY.CATPart
AAE451_T7_FULLFINALASSY.CATProduct
AAE451_T7_ForwardGliderInterface.CATPart
AAE451_T7_FrontLandingGear Plate.CATPart
AAE451_T7_FrontLandingGear.CATProduct
AAE451_T7_FuselageAssy.CATProduct
AAE451_T7_FuselageBody.CATPart
AAE451_T7_FuselageBodyBase.CATPart
AAE451_T7_FuselageBodyTop.CATPart
AAE451_T7_FuselageRod.CATPart
AAE451_T7_HSLH.CATPart
AAE451_T7_HSMID.CATPart
AAE451_T7_HSRH.CATPart
AAE451_T7_HorizontalStabilizer.CATPart
AAE451_T7_HorizontalStabilizerMID.CATPart
AAE451_T7_HorzStabilizerSpar.CATPart
AAE451_T7_NACA0010.CATPart
AAE451_T7_NACA2412.CATPart
AAE451_T7_PlaneAssembly.CATProduct
AAE451_T7_Rudder.CATPart
AAE451_T7_Survo.CATPart
AAE451_T7_VertStabilizerSpar.CATPart
AAE451_T7_VerticalStabilizer.CATPart
AAE451_T7_VerticalStabilizerCut.CATPart
AAE451_T7_VerticalStabilizerCutL.CATPart
AAE451_T7_VerticalStabilizerCutR.CATPart
AAE451_T7_Wing.CATPart
AAE451_T7_WingAttachment.CATPart
AAE451_T7_WingEndCapLH.CATPart
AAE451_T7_WingEndCapRH.CATPart
AAE451_T7_WingFlap.CATPart
AAE451_T7_WingMID.CATPart
AAE451_T7_WingMIDFlap.CATPart
AAE451_T7_WingSpar.CATPart
AAE451_T7_Wing_L_in.CATPart
AAE451_T7_Wing_L_out.CATPart
AAE451_T7_Wing_R_in.CATPart
AAE451_T7_Wing_R_out.CATPart
Assembly_11-21/AAE451_T7_AftLandingGearPlate.CATPart
Assembly_11-21/AAE451_T7_Boom.CATPart
Assembly_11-21/AAE451_T7_FrontLandingGear.CATProduct
Assembly_11-21/AAE451_T7_FuselageAssemble_V2/AAE451_T7_Electronics/AAE451_T7_Battery.CATPart
Assembly_11-21/AAE451_T7_FuselageAssemble_V2/AAE451_T7_Electronics/AAE451_T7_ElectronicPlatform.CATPart
Assembly_11-21/AAE451_T7_FuselageAssemble_V2/AAE451_T7_Electronics/AAE451_T7_ElectronicsBay.CATProduct
Assembly_11-21/AAE451_T7_FuselageAssemble_V2/AAE451_T7_Electronics/ESC.CATPart
Assembly_11-21/AAE451_T7_FuselageAssemble_V2/AAE451_T7_FuselageAssemble_V2/AAE451_T7_Electronics/AAE451_T7_Battery.CATPart
Assembly_11-21/AAE451_T7_FuselageAssemble_V2/AAE451_T7_FuselageAssemble_V2/AAE451_T7_Electronics/AAE451_T7_ElectronicPlatform.CATPart
Assembly_11-21/AAE451_T7_FuselageAssemble_V2/AAE451_T7_FuselageAssemble_V2/AAE451_T7_Electronics/AAE451_T7_ElectronicsBay.CATProduct
Assembly_11-21/AAE451_T7_FuselageAssemble_V2/AAE451_T7_FuselageAssemble_V2/AAE451_T7_Electronics/ESC.CATPart
Assembly_11-21/AAE451_T7_FuselageAssemble_V2/AAE451_T7_FuselageAssemble_V2/AAE451_T7_FuselageAssy_V2.CATProduct
Assembly_11-21/AAE451_T7_FuselageAssemble_V2/AAE451_T7_FuselageAssemble_V2/AAE451_T7_FuselageBodyBase_V2_1.CATPart
Assembly_11-21/AAE451_T7_FuselageAssemble_V2/AAE451_T7_FuselageAssemble_V2/AAE451_T7_FuselageBodyBase_V2_2.CATPart
Assembly_11-21/AAE451_T7_FuselageAssemble_V2/AAE451_T7_FuselageAssemble_V2/AAE451_T7_FuselageBodyTop_V2_1.CATPart
Assembly_11-21/AAE451_T7_FuselageAssemble_V2/AAE451_T7_FuselageAssemble_V2/AAE451_T7_FuselageBodyTop_V2_2.CATPart
Assembly_11-21/AAE451_T7_FuselageAssemble_V2/AAE451_T7_FuselageAssy_V2.CATProduct
Assembly_11-21/AAE451_T7_FuselageAssemble_V2/AAE451_T7_FuselageBodyBase_V2_1.CATPart
Assembly_11-21/AAE451_T7_FuselageAssemble_V2/AAE451_T7_FuselageBodyBase_V2_2.CATPart
Assembly_11-21/AAE451_T7_FuselageAssemble_V2/AAE451_T7_FuselageBodyTop_V2_1.CATPart
Assembly_11-21/AAE451_T7_FuselageAssemble_V2/AAE451_T7_FuselageBodyTop_V2_2.CATPart
Assembly_11-21/AAE451_T7_GliderAttachmentServo.CATPart
Assembly_11-21/AAE451_T7_GliderRod.CATPart
Assembly_11-21/AAE451_T7_LandingGearWheel.CATPart
Assembly_11-21/AAE451_T7_Propeller.CATPart
Assembly_11-21/AAE451_T7_TailAssembly_V2/AAE451_T7_Elevator_V2.CATPart
Assembly_11-21/AAE451_T7_TailAssembly_V2/AAE451_T7_Elevator_V2_1.CATPart
Assembly_11-21/AAE451_T7_TailAssembly_V2/AAE451_T7_Elevator_V2_2.CATPart
Assembly_11-21/AAE451_T7_TailAssembly_V2/AAE451_T7_Elevator_V2_3.CATPart
Assembly_11-21/AAE451_T7_TailAssembly_V2/AAE451_T7_Elevator_V2_4.CATPart
Assembly_11-21/AAE451_T7_TailAssembly_V2/AAE451_T7_Elevator_V2_5.CATPart
Assembly_11-21/AAE451_T7_TailAssembly_V2/AAE451_T7_Elevator_V2_6.CATPart
Assembly_11-21/AAE451_T7_TailAssembly_V2/AAE451_T7_Elevator_V2_Half.CATPart
Assembly_11-21/AAE451_T7_TailAssembly_V2/AAE451_T7_HSLH_V2.CATPart
Assembly_11-21/AAE451_T7_TailAssembly_V2/AAE451_T7_HSMID_V2.CATPart
Assembly_11-21/AAE451_T7_TailAssembly_V2/AAE451_T7_HSRH_V2.CATPart
Assembly_11-21/AAE451_T7_TailAssembly_V2/AAE451_T7_Rudder_V2.CATPart
Assembly_11-21/AAE451_T7_TailAssembly_V2/AAE451_T7_TailAssembly.CATProduct
Assembly_11-21/AAE451_T7_TailAssembly_V2/AAE451_T7_VerticalStabilizerCutL_V2.CATPart
Assembly_11-21/AAE451_T7_TailAssembly_V2/AAE451_T7_VerticalStabilizerCutR_V2.CATPart
Assembly_11-21/AAE451_T7_WingAssembly_V2/AAE451_T7_FullWingAssy.CATProduct
Assembly_11-21/AAE451_T7_WingAssembly_V2/AAE451_T7_LHWingAssy.CATProduct
Assembly_11-21/AAE451_T7_WingAssembly_V2/AAE451_T7_RHWingAssy.CATProduct
Assembly_11-21/AAE451_T7_WingAssembly_V2/AAE451_T7_WingMID_V2.CATPart
Assembly_11-21/AAE451_T7_WingAssembly_V2/AAE451_T7_Wing_LIN_V2.CATPart
Assembly_11-21/AAE451_T7_WingAssembly_V2/AAE451_T7_Wing_L_out_V2.CATPart
Assembly_11-21/AAE451_T7_WingAssembly_V2/AAE451_T7_Wing_RIN_V2.CATPart
Assembly_11-21/AAE451_T7_WingAssembly_V2/AAE451_T7_Wing_R_out_V2.CATPart
Assembly_11-21/AAE451_T7_WingAssembly_V6/AAE451_T7_WingAssembly_V2/AAE451_T7_FullWingAssy.CATProduct
Assembly_11-21/AAE451_T7_WingAssembly_V6/AAE451_T7_WingAssembly_V2/AAE451_T7_LHWingAssy.CATProduct
Assembly_11-21/AAE451_T7_WingAssembly_V6/AAE451_T7_WingAssembly_V2/AAE451_T7_RHWingAssy.CATProduct
Assembly_11-21/AAE451_T7_WingAssembly_V6/AAE451_T7_WingAssembly_V2/AAE451_T7_WingEndCapLH_V2.CATPart
Assembly_11-21/AAE451_T7_WingAssembly_V6/AAE451_T7_WingAssembly_V2/AAE451_T7_WingEndCapRH_V2.CATPart
Assembly_11-21/AAE451_T7_WingAssembly_V6/AAE451_T7_WingAssembly_V2/AAE451_T7_WingFlap_V2.CATPart
Assembly_11-21/AAE451_T7_WingAssembly_V6/AAE451_T7_WingAssembly_V2/AAE451_T7_WingMIDFlap_V2.CATPart
Assembly_11-21/AAE451_T7_WingAssembly_V6/AAE451_T7_WingAssembly_V2/AAE451_T7_WingMID_V2.CATPart
Assembly_11-21/AAE451_T7_WingAssembly_V6/AAE451_T7_WingAssembly_V2/AAE451_T7_Wing_LIN_V2.CATPart
Assembly_11-21/AAE451_T7_WingAssembly_V6/AAE451_T7_WingAssembly_V2/AAE451_T7_Wing_L_out_V2.CATPart
Assembly_11-21/AAE451_T7_WingAssembly_V6/AAE451_T7_WingAssembly_V2/AAE451_T7_Wing_RIN_V2.CATPart
Assembly_11-21/AAE451_T7_WingAssembly_V6/AAE451_T7_WingAssembly_V2/AAE451_T7_Wing_R_out_V2.CATPart
Assembly_11-21/AAE451_T7_WingAssembly_V6/AAE451_T7_WingAssembly_V2/AAE451_T7_Wing_TESTPRINT.CATPart
Assembly_11-21/AAE451_T7_WingAttachment_V2.CATPart
Assembly_11-21/Poseidon.CATProduct
Assembly_11-21/Posiden_2.CATProduct
Assembly_11-21/TRIDENT11-20/ElevonLeft11-19.CATPart
Assembly_11-21/TRIDENT11-20/ElevonRight11-19.CATPart
Assembly_11-21/TRIDENT11-20/FullModel11-20.CATProduct
Assembly_11-21/TRIDENT11-20/Fuselage11-19.CATPart
Assembly_11-21/TRIDENT11-20/LeftWinglet11-06 (1).CATPart
Assembly_11-21/TRIDENT11-20/RightWing.CATPart
Assembly_11-21/TRIDENT11-20/RightWinglet11-06.CATPart
Assembly_11-21/TRIDENT11-20/Rudder11-14.CATPart
Assembly_11-21/TRIDENT11-20/RudderControlSurface11-14.CATPart
Assembly_11-21/TRIDENT11-20/ServoHousingLeft11-19.CATPart
Assembly_11-21/TRIDENT11-20/ServoHousingRight11-19.CATPart
Assembly_11-21/TRIDENT11-20/nosepiece11-20.CATPart
Assembly_11-21/TRIDENT11-20/nosepiece_hatch.CATPart
Assembly_11-21/motor.CATPart
ESC.SLDPRT
Old CAD/AAE451_T7_AftGliderInterface.CATPart
Old CAD/AAE451_T7_AftLandingGear.CATProduct
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
