bdubyalock/AAE451_Team7/(commit log)

2019-09-19 Create CDR.xfl
    Added a copy of the current XFLR model. Use this for stability analysis, etc
2019-09-26 Create AAE451_T7_Survo.CATPart
    https://hitecrcd.com/products/servos/micro-and-mini-servos/digital-micro-and-mini-servos/hs-5055mg-economy-metal-gear-feather-servo/product
    [AAE451_T7_Survo.CATPart]
2019-09-26 Create Propulsion Combination (Gearless).xlsx
    [Propulsion Combination (Gearless).xlsx]
2019-09-26 Update Propulsion Combination (Gearless).xlsx
    [Propulsion Combination (Gearless).xlsx]
2019-09-27 Added PDR Propeller Calculation Document
    This is the final version of the spreadsheet used for the Propulsion PDR
    [PROPELLER_PDR_Design.xlsx]
2019-10-01 Added wing weight calculations
    How much should the wing be filled to meet the current weight distribution?
2019-10-03 Add files via upload
    cad
    [AAE451_T7_FuselageBody.CATPart, AAE451_T7_HorizontalStabilizer.CATPart, AAE451_T7_NACA0010.CATPart, AAE451_T7_NACA2412.CATPart, AAE451_T7_PlaneAssembly.CATProduct, AAE451_T7_VerticalStabilizer.CATPart, AAE451_T7_Wing.CATPart]
2019-10-12 Changed constraints on glider attachments to ensure they are aligned and visible. I don't expect that the current locations will be perfect, but since we are not printing them, I think it should be g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
    [AAE451_T7_FuselageAssy.CATProduct]
2019-10-12 Created a template to build 3 View Drawings. Needs vert stabilizers and gears still
2019-10-12 box electronics
    [Batt.SLDPRT, ESC.SLDPRT, motor.SLDPRT]
2019-10-12 Added battery model based on dimensions found online
    [AAE451_T7_Battery.CATPart]
2019-10-12 Added RC Controller from GrabCad
    [AR8000.stl]
2019-10-13 Added glider attachment to the final assembly
    [AAE451_T7_FULLFINALASSY.CATProduct, AAE451_T7_FrontLandingGear Plate.CATPart, AAE451_T7_FuselageBodyBase.CATPart, AAE451_T7_VerticalStabilizerCutL.CATPart, AAE451_T7_VerticalStabilizerCutR.CATPart, AAE451_T7_Wing_R_out.CATPart]
2019-10-13 Added electrical components
    [AAE451_T7_FULLFINALASSY.CATProduct, AAE451_T7_FrontLandingGear Plate.CATPart, AAE451_T7_FuselageBodyTop.CATPart, AAE451_T7_Survo.CATPart, AAE451_T7_WingMID.CATPart, ESC.CATPart, ESC.STEP, motor.CATPart]
2019-10-15 Weight Estimate of 3D printed Parts
    [Filament Weight Estimator.xlsx]
2019-10-15 Add Propulsion and CDR Slides from after CDR Draft Day
    [PROPELLER_CDR_DRAFT_RDONLY.xlsx]
2019-10-15 Weight Estimate
    [Filament Weight Estimator.xlsx]
2019-10-22 Added Consolidated numbers
    [CostSpreadsheet.xlsx]
2019-10-22 Added for the new shortened flight time
    [PROPELLER_ShortFlight.xlsx]
2019-10-22 Update for new battery: Turnigy 5000 mAh 6S 25C LiPo
    [PROPELLER_ShortFlight.xlsx]
2019-10-29 Fuselage and Wing assemblies with fastener holes
2019-10-29 New weight estimate
    [WeightEstimate.xlsx]
2019-10-30 Wing Test Print
    [AAE451_T7_Wing_TESTPRINT.CATPart]
2019-10-31 Updated wing assembly
    pegs for glued parts and bolt holes
2019-10-31 Updated fuselage assembly
2019-10-31 Brass insert test piece
    [AAE451_T7_BrassInsertTest.CATPart]
2019-10-31 Adding final Propulsion Calculations
    [PROPELLER_FINAL.xlsx]
2019-11-04 Changed tolerance on fit between wing pieces
2019-11-05 Wire slots
    [AAE451_T7_WingMID.CATPart, AAE451_T7_Wing_L_in.CATPart, AAE451_T7_Wing_L_out.CATPart, AAE451_T7_Wing_R_in.CATPart, AAE451_T7_Wing_R_out.CATPart]
2019-11-06 WIRE SLOT WITH SURVO SLOT
2019-11-06 Changed tolerance between wing pieces
2019-11-06 Made smaller
    [AAE451_T7_BrassInsertTest.CATPart]
2019-11-06 Print Please
    [AAE451_T7_Elevator_V2_Half.CATPart]
2019-11-06 WING ASSEMBLY WITH SLOTS
2019-11-07 FINAL WING
2019-11-08 FINAL WING
    Updated holes for wing caps to accommodate the brass inserts.
2019-11-10 Fuselage with electronics attachments
2019-11-11 Created Payload Attachment Servo CAD
    [AAE451_T7_GliderAttachmentServo.CATPart]
2019-11-12 Wing attachment
    [AAE451_T7_WingAttachment_V2.CATPart]
2019-11-12 Wing attach pegs added
2019-11-13 Updated for Glider Attachment System
    [AAE451_T7_AftLandingGearPlate.CATPart, AAE451_T7_FULLFINALASSY.CATProduct, AAE451_T7_FrontLandingGear Plate.CATPart, AAE451_T7_FuselageBodyBase.CATPart, AAE451_T7_FuselageBodyTop.CATPart, AAE451_T7_GliderAttachmentServo.CATPart, AAE451_T7_GliderRod.CATPart, AAE451_T7_WingMID.CATPart]
2019-11-14 Fuselage with correct brass insert holes
    Glider attachment still not included
2019-11-14 Add files via upload
    brass insert + holes for motor attachment
2019-11-21 Added TRIDENT glider and Poseidon (full assembly with MAMA and TRIDENT
    [AAE451_T7_FULLFINALASSY.CATProduct, AAE451_T7_FrontLandingGear Plate.CATPart, AAE451_T7_FrontLandingGear.CATProduct, AAE451_T7_FuselageBodyBase.CATPart, AAE451_T7_GliderRod.CATPart, ElevonLeft11-19.CATPart, ElevonRight11-19.CATPart, FullModel11-20.CATProduct]
2019-11-21 Adding Assembly folder for November 21st
    [AAE451_T7_Battery.CATPart, AAE451_T7_ElectronicsBay.CATProduct, AAE451_T7_Elevator_V2.CATPart, AAE451_T7_Elevator_V2_1.CATPart, AAE451_T7_Elevator_V2_1.stl, AAE451_T7_Elevator_V2_2.CATPart, AAE451_T7_Elevator_V2_2.stl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]
2019-11-21 Updated fuselage base for final attachment geometry
    [AAE451_T7_FullWingAssy.CATProduct, AAE451_T7_FuselageAssy_V2.CATProduct, AAE451_T7_FuselageBodyBase_V2_2.CATPart, AAE451_T7_GliderAttachmentServo.CATPart, AAE451_T7_GliderRod.CATPart, AAE451_T7_Wing_L_out_V2.CATPart, ElevonLeft11-19.CATPart, ElevonRight11-19.CATPart]
2019-11-21 Added Zipped version of Nov 21 assembly
2019-11-21 Organized
    Old Cad Moved to New Folder
    [AAE451_T7_AftGliderInterface.CATPart, AAE451_T7_AftLandingGear.CATProduct, AAE451_T7_AftLandingGearPlate.CATPart, AAE451_T7_Battery.CATPart, AAE451_T7_Boom.CATPart, AAE451_T7_BrassInsertTest.CATPart, AAE451_T7_Elevator.CATPart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]
2019-11-22 Updated Holes
    [AAE451_T7_FULLFINALASSY.CATProduct, AAE451_T7_FullWingAssy.CATProduct, AAE451_T7_LHWingAssy.CATProduct, AAE451_T7_RHWingAssy.CATProduct, AAE451_T7_WingEndCapLH_V2.CATPart, AAE451_T7_WingEndCapRH_V2.CATPart, AAE451_T7_WingFlap_V2.CATPart, AAE451_T7_WingMIDFlap_V2.CATPart]
2019-11-22 sean fix this plz
    [AAE451_T7_FullWingAssy.CATProduct, AAE451_T7_LHWingAssy.CATProduct, AAE451_T7_WingMID_V2.CATPart, AAE451_T7_Wing_L_out_V2.CATPart]
2019-11-22 FIXED SLOTS
    [AAE451_T7_Wing_L_out_V2.CATPart, AAE451_T7_Wing_R_out_V2.CATPart]
2019-11-23 fixed wing parts
    [AAE451_T7_Wing_L_out_V2.CATPart, AAE451_T7_Wing_L_out_V2.stl, AAE451_T7_Wing_R_out_V2.CATPart, AAE451_T7_Wing_R_out_V2.stl]
2019-11-23 Updated Assembly
    With rear landing gear, No mounting holes?
    [AAE451_T7_AftLandingGearPlate.CATPart, AAE451_T7_FullWingAssy.CATProduct, AAE451_T7_FuselageAssy_V2.CATProduct, AAE451_T7_LandingGearWheel.CATPart, Poseidon.CATProduct]
2019-11-23 propeller added to assembly
    [AAE451_T7_FullWingAssy.CATProduct, AAE451_T7_FuselageAssy_V2.CATProduct, AAE451_T7_Propeller.CATPart, Poseidon.CATProduct, motor.CATPart]
2019-11-25 fixed spar hole
    [AAE451_T7_FullWingAssy.CATProduct, AAE451_T7_LHWingAssy.CATProduct, AAE451_T7_RHWingAssy.CATProduct, AAE451_T7_WingMID_V2.CATPart, AAE451_T7_Wing_LIN_V2.CATPart, AAE451_T7_Wing_L_out_V2.CATPart, AAE451_T7_Wing_RIN_V2.CATPart, AAE451_T7_Wing_R_out_V2.CATPart]
2019-12-07 Added new center wing
    [AAE451_T7_FullWingAssy.CATProduct, AAE451_T7_LHWingAssy.CATProduct, AAE451_T7_RHWingAssy.CATProduct, AAE451_T7_WingAttachment_V2.CATPart, AAE451_T7_WingEndCapLH_V2.CATPart, AAE451_T7_WingEndCapRH_V2.CATPart, AAE451_T7_WingFlap_V2.CATPart, AAE451_T7_WingMIDFlap_V2.CATPart]
2019-12-10 Add files via upload
    Maybe most up to date V-n?
    [AA-SM-518 Loads - V-n Diagram -Sarah.xlsx]
